FKI-HTW/VENTUS/Assets/Sprites/brown-Eye.png

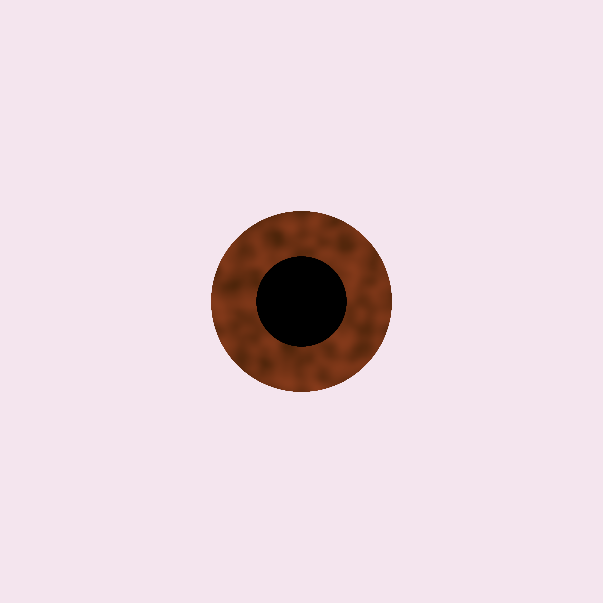
Assets/Sprites/brown-Eye.png
