FKI-HTW/VENTUS/Assets/Sprites/Donut.png

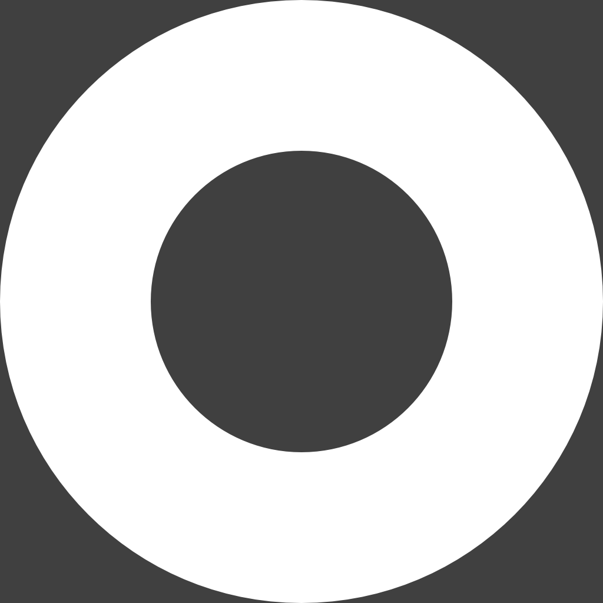
Assets/Sprites/Donut.png
