FKI-HTW/VENTUS/Assets/Sprites/DonutSlice.png

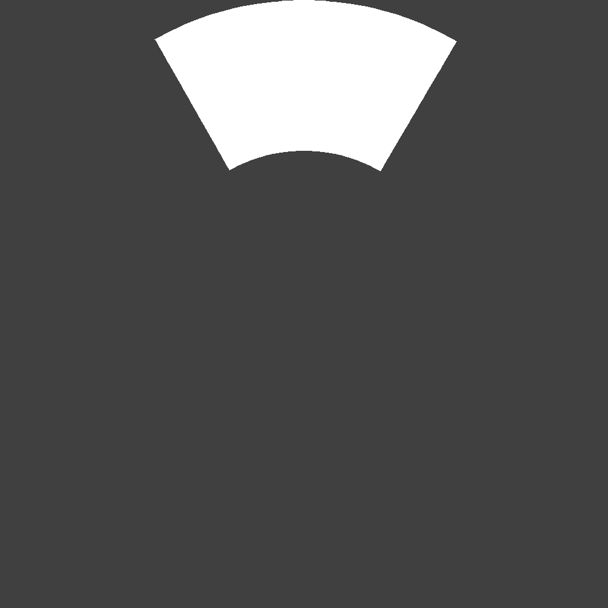
Assets/Sprites/DonutSlice.png
