FKI-HTW/VENTUS/Assets/Sprites/DonutSliceBig.png

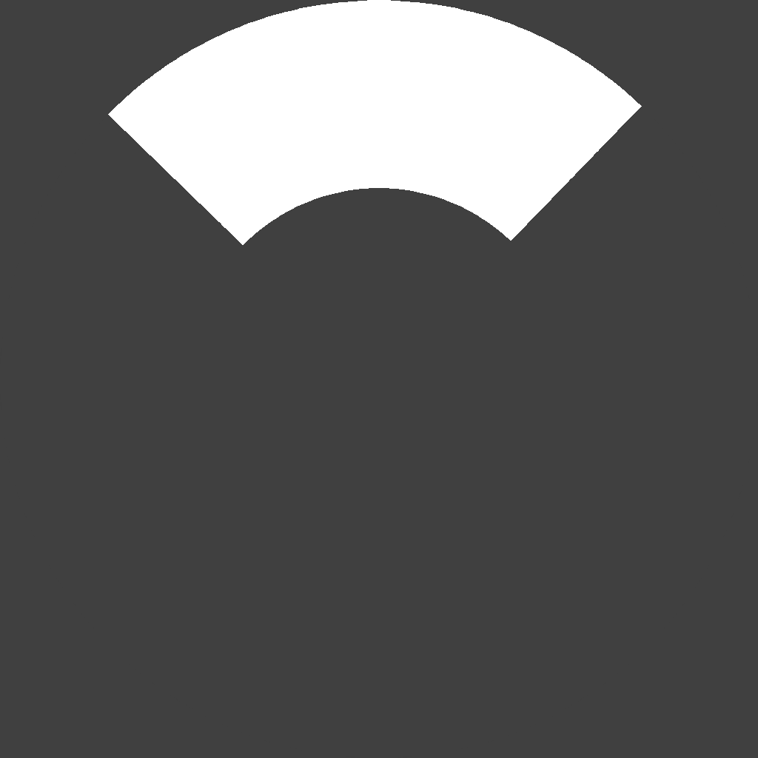
Assets/Sprites/DonutSliceBig.png
