FKI-HTW/VENTUS/Assets/Sprites/DonutThin.png

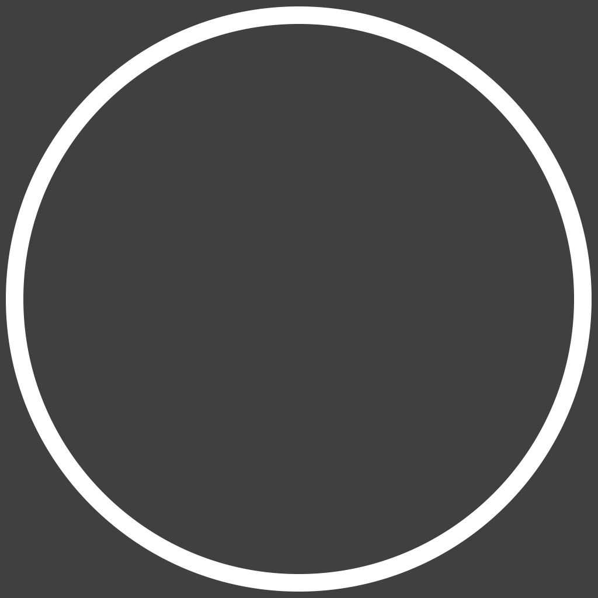
Assets/Sprites/DonutThin.png
