FKI-HTW/VENTUS/Assets/Sprites/FadedBorder.png

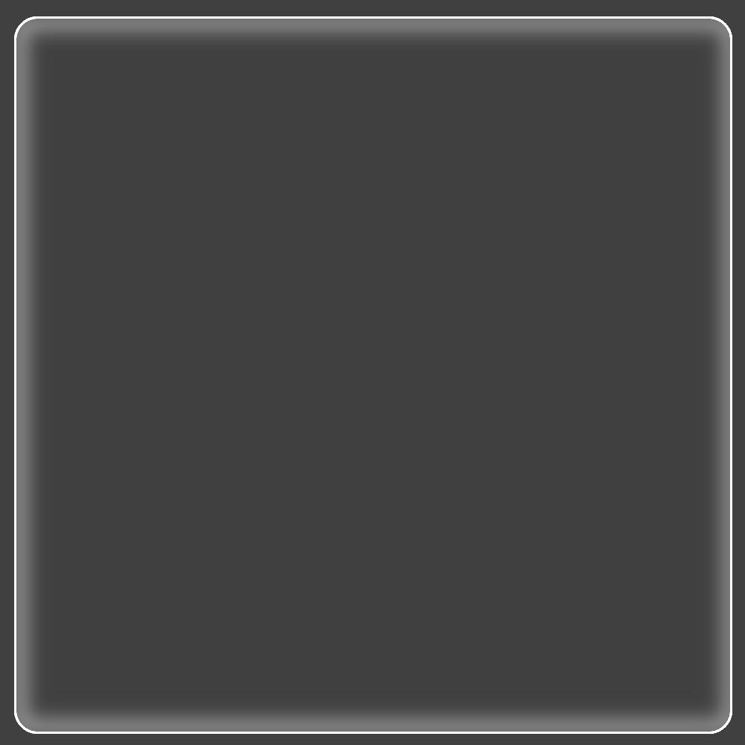
Assets/Sprites/FadedBorder.png
