FKI-HTW/VENTUS/Assets/Sprites/Grid.png

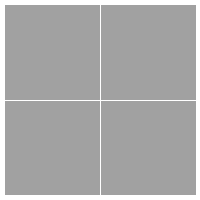
Assets/Sprites/Grid.png
