FKI-HTW/VENTUS/Assets/StreamingAssets/LibraryModels/Platform.stp

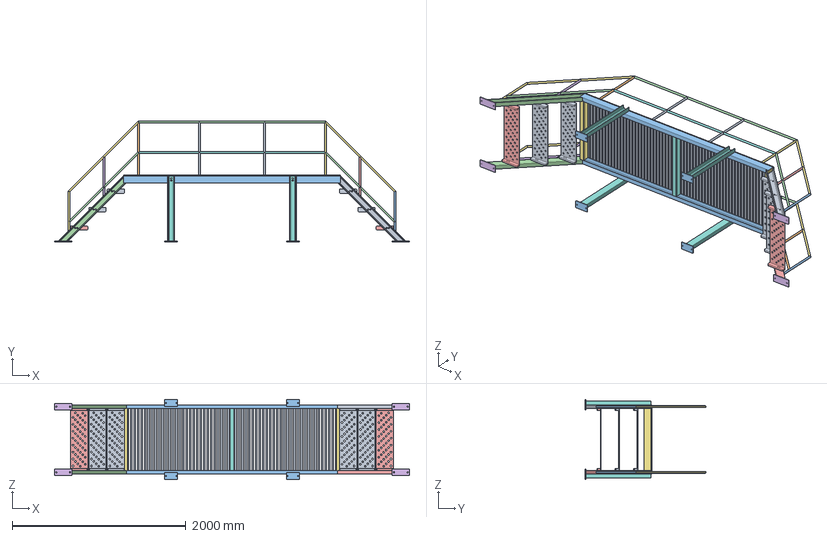
[picture p10: CAD file, 2024-05-01]
Assets/StreamingAssets/LibraryModels/Platform.stp
4086.9 x 1391.1 x 922.7 mm
Combinar2
Simetría5[4]
Saliente-Extruir4[6]
Miembro estructural3[11]
Simetría5[11]
Simetría5[5]
Simetría5[3]
Simetría5[2]
Saliente-Extruir4[1]
Cortar-Extruir1[4]
Combinar5
Combinar6
Recortar/Extender3[1]
Recortar/Extender5[3]
Simetría5[15]
Recortar/Extender8[2]
Recortar/Extender5[2]
Miembro estructural3[18]
Combinar4
Saliente-Extruir4[2]
Recortar/Extender9[1]
Simetría5[16]
Miembro estructural3[16]
Miembro estructural3[13]
Simetría5[9]
Simetría5[13]
Simetría5[10]
Saliente-Extruir4[7]
Cortar-Extruir5[1]
Recortar/Extender3[3]
Simetría5[8]
Recortar/Extender8[1]
Recortar/Extender5[1]
Simetría5[6]
Cortar-Extruir1[5]
Cortar-Extruir1[3]
Miembro estructural3[12]
Cortar-Extruir3
Simetría5[14]
Miembro estructural3[15]
Simetría5[7]
Recortar/Extender5[4]
Saliente-Extruir4[5]
Saliente-Extruir4[8]
Cortar-Extruir1[2]
Recortar/Extender9[2]
Simetría5[1]
Saliente-Extruir4[3]
Cortar-Extruir5[3]
Miembro estructural3[17]
Cortar-Extruir5[4]
Combinar1
Simetría5[17]
Simetría5[18]
Cortar-Extruir1[1]
Combinar3
Miembro estructural1[2]
Miembro estructural1[5]
Cortar-Extruir1[6]
Miembro estructural3[14]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
