FKI-HTW/VENTUS/docs/user/usage.markdown

---
layout: page
title: Usage
permalink: /user/usage
nav_order: 2
parent: User Documentation
---

## Usage

### Controls

<video width="50%" height="auto" autoplay muted loop>
<source src="https://github.com/FKI-HTW/VENTUS/raw/develop/Assets/StreamingAssets/GlossaryVideos/controller.mp4" type="video/mp4">
</video>

To move around your scene in Desktop-Mode, please keep the right mouse button pressed while using the WASD-keys to navigate. To move to the right press ‘D’, to move to the left press ‘A’, to move forward press ‘W’ and to move back press ‘S’. It is also possible to press more keys then one to combine movements. To interact with any object or interface, please press the left mouse button.
To interact with an item or interface in VR-Mode please press the trigger button underneath your controller as indicated through a tooltip when waiting for a view seconds. To move around in VR you can push the analog-stick forward, while aiming at your desired destination. Releasing the analog then starts the teleport.

---

### VR-Keyboard

Whenever you click on an input field in VR a keyboard will open. There are different keyboards for example a small one for numbers and a bigger one for text input. Just click on the different keys to write and confirm your input through clicking on the green arrow confirm button.

---

### Draggable Panels

<video width="50%" height="auto" autoplay muted loop>
<source src="https://github.com/FKI-HTW/VENTUS/raw/develop/Assets/StreamingAssets/GlossaryVideos/dragWindows.mp4" type="video/mp4">
</video>

All panels like the taskbar and top windows, the transform window or the input windows for annotations can be dragged to a position you prefer. When hovering over any window, you will see a light outline around it. Just press the trigger button when the outline is there, move the window to its new position while pressing the trigger button and release it wherever you would like the window to be placed for now.
