FKI-HTW/VENTUS/(notices)

Notices in the files:
Assets/StreamingAssets/LibraryModels/Eurokastenwagen.stp:
FILE_NAME( 'p:/temp/export_3576_2596_BMJQN/3576_32.stp', '2023-09-25T10:39:00', ( 'License CC BY-ND 4.0' ), ( 'CADENAS' ), ' ', 'PARTsolutions', ' ' );
Assets/StreamingAssets/LibraryModels/Platform.stp:
FILE_NAME( 'p:/temp/export_3576_2588_IJE2I/3576_2320.stp', '2023-09-25T10:18:27', ( 'License CC BY-ND 4.0' ), ( 'CADENAS' ), ' ', 'PARTsolutions', ' ' );
